2gymchrysoupolis/2gym-sensors/MEASUREMENTS.png

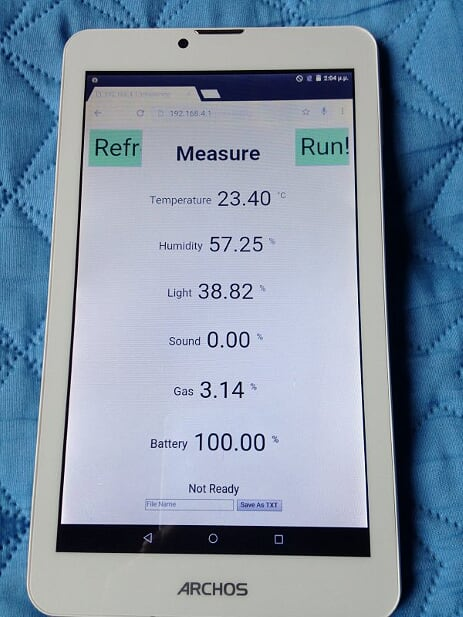
MEASUREMENTS.png
