2gymchrysoupolis/2gym-sensors/IMG_0323.JPG

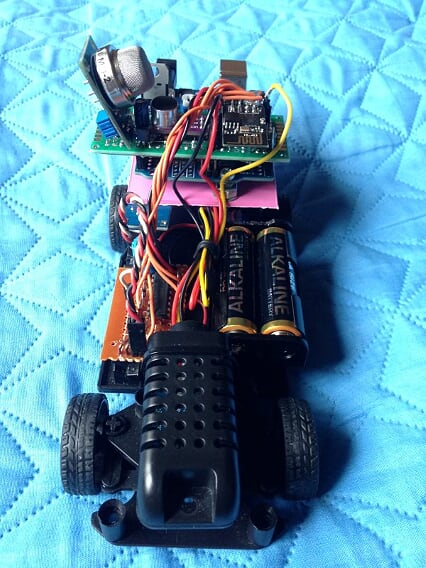
IMG_0323.JPG
