2gymchrysoupolis/2gym-sensors/README.md

# 2gym-sensorsΤο έργο μας έχει σκοπό:
Να καλλιεργήσει το ομαδικό πνεύμα και την συνεργασία των μαθητών προς ένα κοινό στόχο.
Να εμπλουτίσει τις γνώσεις τους σε ένα καινοτόμο τομέα και να τους ανοίξει ορίζοντες για την μετέπειτα εξέλιξή τους.
Να ενθαρρύνει τους μαθητές να αποκτήσουν σημαντικές δεξιότητες στην ρομποτική.
Για το έργο μας θα χρειαστούμε:
Υλικά για το περιβαλλοντικό πολύμετρο :

Όνομα / Κωδικός / Τιμή / Κατάστημα
1)Τηλεκατευθυνόμενο Αγωνιστικό Αυτοκίνητο Μπαταρίας με Χειριστήριο (1:24) - 27MHz / 1159201 / 4,99 € / JUMBO
2)ΑΛΚΑΛΙΚΗ ΜΠΑΤΑΡΙΑ ΑΑ 1.5 V LR6 BLISTER 5τεμ (4+1) - (147-24153) EUROLAMP / 13911 / 0,99 € / caliston.gr
3)CJMCU-9812 MAX9812L Electret Microphone Amplifier Development Board / 070.9469 / €3.30 / hellasdigital
4)DHT21 AM2301 Digital Temperature Humidity Sensor module with SHT11 SHT15 for Arduino / 070.0547 / €6.50 / hellasdigital
5)2*9.5mm active buzzer 5V / 070.9248 / €0.40 / hellasdigital
6)ESP8266 ESP-01 WiFi Serial Transceiver Module LWIP AP+STA for Arduino / 054.0332 / €4.19 / hellasdigital
7)RGB Diffused Common Cathode 5mm LED / 070.1500 / €0.25 / hellasdigital
8)Photo Light Sensitive Resistor 5mm GL5539 / 054.0303 / €0.15 / hellasdigital
9)SET OEM UNO R3 (ATmega328P) includes USB Cable, 40pin Headers Compatible with Arduino IDE / 033.0826 / €6.94 / hellasdigital
10)Αντίσταση Carbon 1/4W 5% 1Kohm / SKU: 05-00145029 / €0.01 x 10 = €0.10 / GROBOTRONICS
11)Transistor PNP 0.5A - BC327 / SKU: 05-00213533 / €0.08 x 2 = €0.16 / GROBOTRONICS
12)Transistor NPN 0.8A - BC337 / SKU: 05-00213524 / €0.08 x 2 = €0.16 / GROBOTRONICS
13)DC Power Plug 5.5x2.1mm – Angled / SKU: 05-00006370 / €0.25 / GROBOTRONICS
14)Battery Holder 2xΑΑ - with Wires / SKU: 05-00032199 / €0.40 / GROBOTRONICS
15)Prototyping Board 30x70mm Double-Sided / SKU: 19-00030706 / €0.50 / GROBOTRONICS
16)MQ-2 Smoke Gas Butane Hydrogen Gas Sensor Module For Arduino/ 054.0418 /€3.50 / hellasdigital

Εργαλεία:

1) Θερμοκόλλα
2) Κολλητήρι
3) Νυστέρι

Προτεινόμενο κόστος 32.78 ευρώ
