2gymchrysoupolis/2gym-sensors/ΜΕΤΡΗΣΕΙΣ-ΚΩΔΙΚΟΙ.docx

Μετρήσεις-Κωδικοί

Επίσης παρατίθενται κάποιοι κωδικοί χρήσης του πολύ-αισθητήρα που είναι οι παρακάτω:

Buzzer

Ανάβει συνεχόμενα: Κόρνα.

Αναβοσβήνει σύντομα 3 φορές: Η μέτρηση ολοκληρώθηκε, χωρίς επικίνδυνα αέρια.

Αναβοσβήνει παρατεταμένα 3 φορές: Η μέτρηση ολοκληρώθηκε, με παρουσία επικίνδυνου αερίου.

LED

Aναβοσβήνει ομαλά πράσινο: Το αμαξάκι λειτουργεί, δεν κινείται, δεν μετράει.

Αναβοσβήνει ομαλά πράσινο με πορτοκαλί: Το αμαξάκι κινείται.

Αναβοσβήνει κόκκινο: Χαμηλή μπαταρία, το αμαξάκι απενεργοποιείται.

Αναβοσβήνει ομαλά κόκκινο με μπλε: Γίνεται μέτρηση.

Αναβοσβήνει ομαλά πράσινο με μπλε: Η μέτρηση ολοκληρώθηκε με επιθυμητά νούμερα.

Αναβοσβήνει ομαλά πράσινο με κόκκινο: Η μέτρηση ολοκληρώθηκε με μη επιθυμητή υγρασία ή θερμοκρασία.

Αναβοσβήνει μπλε και κόκκινο: Η μέτρηση ολοκληρώθηκε με παρουσία επικίνδυνου αερίου.

Wire colors

Μαύρο: Γείωση

Κόκκινο: 5V

Πορτοκαλί: 3.3V

Κίτρινο: Analog Inputs

Πράσινο: Σειριακή Επικοινωνία

Γαλάζιο: Digital Pins

Μπλε: Άλλο

Μωβ: 7.2V

Όχρα: V_battery
