2gymchrysoupolis/2gym-sensors/ΟΜΑΔΑ ΕΡΓΑΣΙΑΣ-ΥΠΕΥΘΥΝΟΣ ΚΑΘΗΓΗΤΗΣ.docx

ΜΑΘΗΤΕΣ

1. ΧΡΥΣΟΠΟΥΛΟΣ ΓΙΩΡΓΟΣ ΤΜΗΜΑ Γ3

2. ΚΥΖΑΚΗΣ ΑΝΤΩΝΗΣ ΤΜΗΜΑ Γ2

3. ΛΕΙΒΑΔΙΤΟΥ ΧΡΥΣΟΥΛΑ-ΠΑΡΑΣΚΕΥΗ ΤΜΗΜΑ Β2

4. ΛΟΥΛΙ ΣΙΝΤΟΡΕΝΑ ΤΜΗΜΑ Β2

5. ΜΑΛΛΙΟΣ ΓΙΑΝΝΗΣ ΤΜΗΜΑ Β2

ΥΠΕΥΘΥΝΟΣ ΚΑΘΗΓΗΤΗΣ: Δρ. ΦΙΛΟΘΟΔΩΡΟΣ ΕΥΑΓΓΕΛΟΣ

ΒΟΗΘΟΣ ΚΑΘΗΓΗΤΗΣ: ΠΑΠΑΤΖΙΚΑΚΗ ΜΑΡΙΑ
