2gymchrysoupolis/2gym-sensors/ΕΠΙΔΙΩΞΕΙΣ.docx

ΕΠΙΔΙΩΞΕΙΣ

Με βάση έρευνα της αμερικανικής κυβέρνησης, φαίνεται ο SARS-Cov2 να αποδυναμώνεται πιο γρήγορα όταν εκτίθεται στον ήλιο, τη ζέστη και την υγρασία, μία ένδειξη ότι η πανδημία ίσως εξαπλώνεται με πιο αργούς ρυθμούς το καλοκαίρι. Λαμβάνοντας υπόψιν ότι οι υψηλές θερμοκρασίες στην Ελλάδα αρχίζουν περί τα τέλη Απριλίου με αρχές Μαΐου είναι ένα αρχικό έναυσμα για να μετρήσει κανείς αυτά τα μεγέθη μέσα σε σχολικές τάξεις που εν δυνάμει αποτελούν από τους σημαντικότερους λόγους διασποράς της ίωσης. Τα ευρήματα αυτά ενισχύουν τις ελπίδες ότι ο κορονοϊός θα μιμηθεί τη συμπεριφορά άλλων αναπνευστικών ασθενειών, όπως η γρίπη, οι οποίες είναι λιγότερο μολυσματικές όταν αυξάνεται η θερμοκρασία. Επίσης η συγκεκριμένη έρευνα έδειξε ότι ο ιός χάνει την ισχύ του κατά τρεις φορές σε περιβάλλον υψηλής υγρασίας και αν αυτό συνδυαστεί και με το φως του ήλιου η διαδικασία αυτή επιταχύνεται ραγδαίως. Πρακτικά θερμοκρασίες άνω των 22 ⁰C και ποσοστά υγρασίας μεγαλύτερα του 60% δημιουργούν μεγάλη δυσκολία στον ιό ώστε να μεταδοθεί (Από άρθρα σε διαδίκτυο). Αυτό συμβαίνει διότι αυτές οι κλιματικές συνθήκες δεν επιτρέπουν σε ιούς της μορφής SARS να παραμένουν στον αέρα και τους ρίχνουν στο έδαφος στο οποίο έχουν μέση διάρκεια ζωής το πολύ 3 ώρες.

Επίσης οι υπόλοιποι αισθητήρες της διάταξης μπορούν να δώσουν τιμές αερίων, φωτός και ήχου μέσα σε έναν κλειστό χώρο όπως μία σχολική τάξη και να γίνει σύγκριση των τιμών αυτών με ιδανικές συνθήκες διαβίωσης και αλληλεπίδρασης μεταξύ των ανθρώπων σε έναν χώρο από τη στιγμή που φαινόμενα όπως η αντήχηση, ο κακός ή υπερβολικός φωτισμός και οι εξωτερικοί θόρυβοι ειδικά σε σχολικά συγκροτήματα που βρίσκονται εντός του κύριου αστικού όγκου, επιβραδύνουν και μειώνουν το επίπεδο της σχολικής διαδικασίας.
