2gymchrysoupolis/2gym-sensors/IMG_0276.JPG

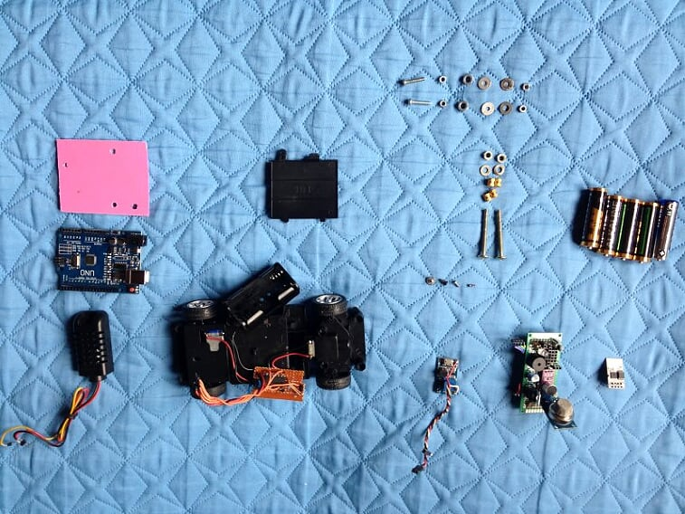
IMG_0276.JPG
