2gymchrysoupolis/2gym-sensors/IMG_0277.JPG

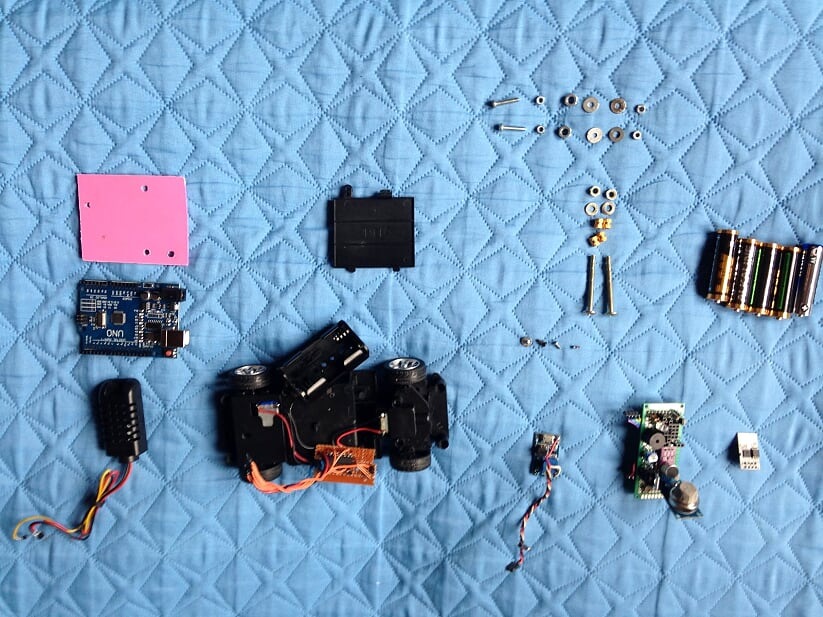
IMG_0277.JPG
