2gymchrysoupolis/2gym-sensors/IMG_0279.JPG

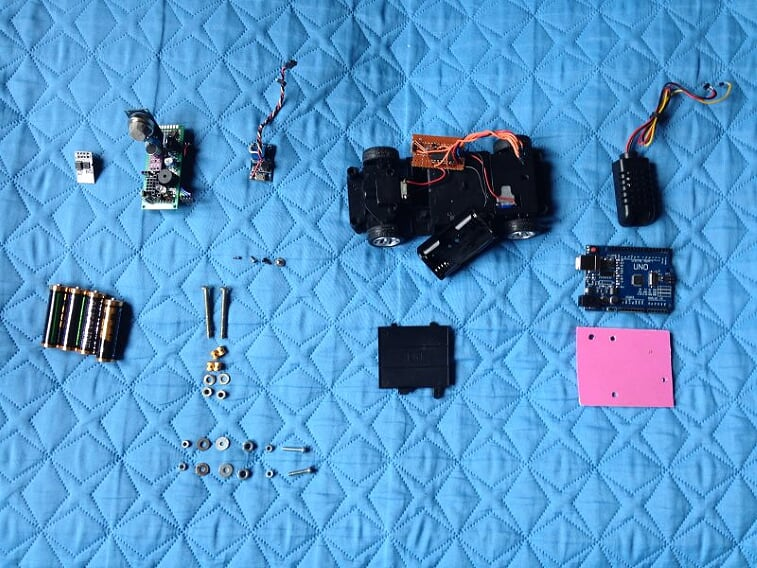
IMG_0279.JPG
