2gymchrysoupolis/2gym-sensors/IMG_0282.JPG

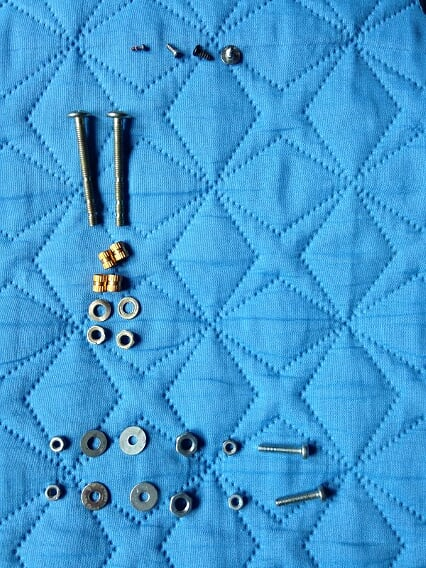
IMG_0282.JPG
