2gymchrysoupolis/2gym-sensors/IMG_0283.JPG

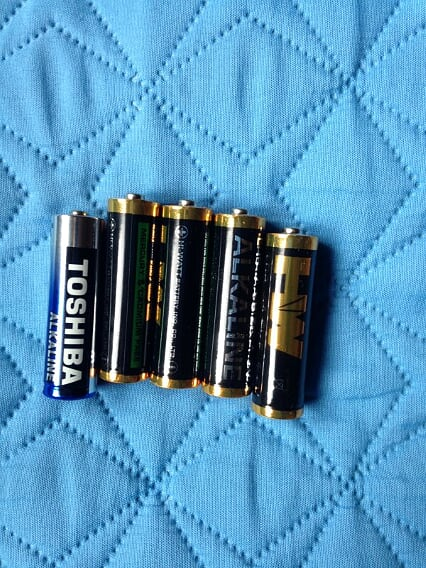
IMG_0283.JPG
