2gymchrysoupolis/2gym-sensors/IMG_0285.JPG

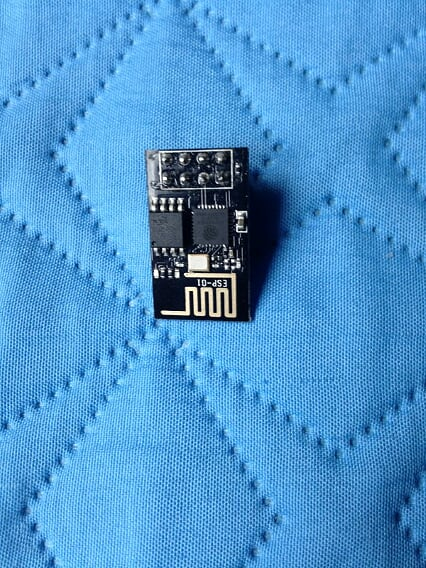
IMG_0285.JPG
