2gymchrysoupolis/2gym-sensors/IMG_0286.JPG

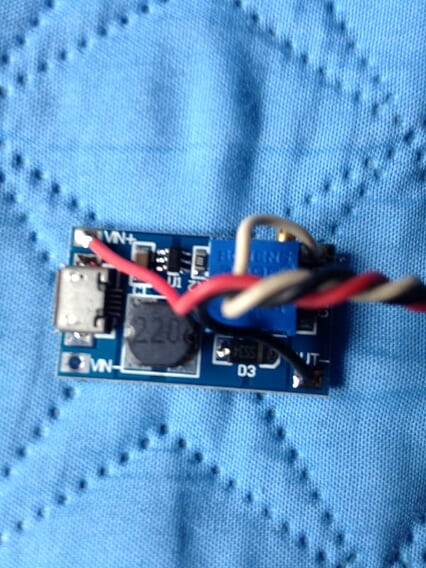
IMG_0286.JPG
