2gymchrysoupolis/2gym-sensors/IMG_0287.JPG

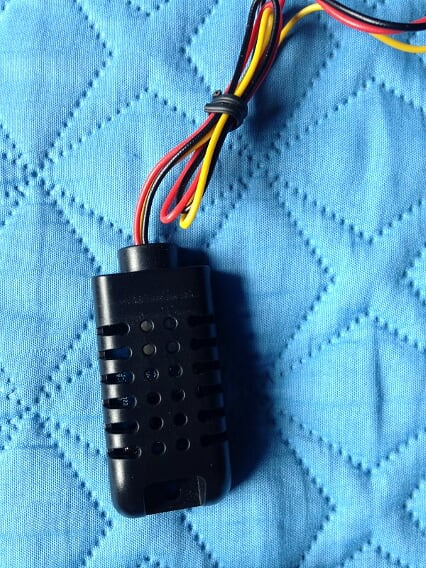
IMG_0287.JPG
