2gymchrysoupolis/2gym-sensors/IMG_0288.JPG

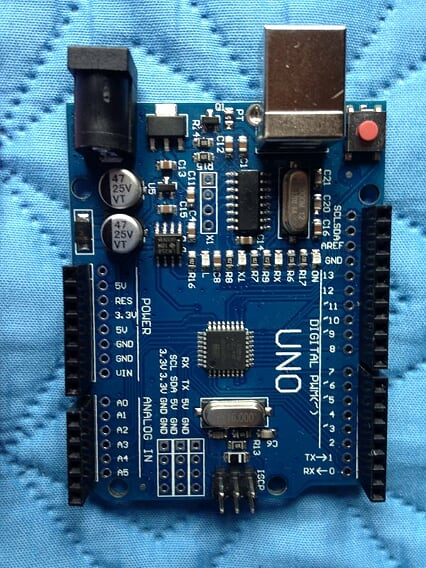
IMG_0288.JPG
