2gymchrysoupolis/2gym-sensors/IMG_0289.JPG

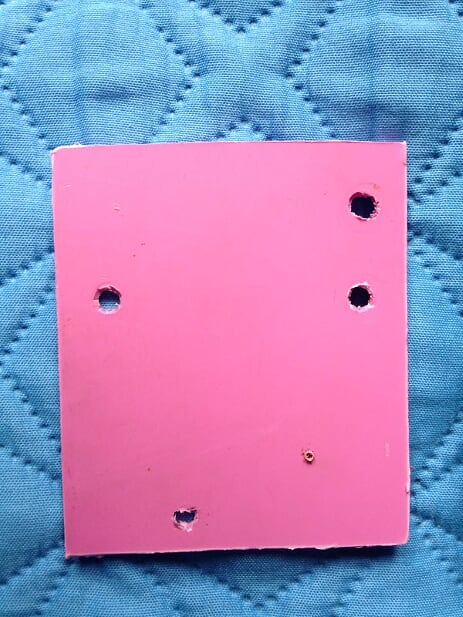
IMG_0289.JPG
