2gymchrysoupolis/2gym-sensors/IMG_0290.JPG

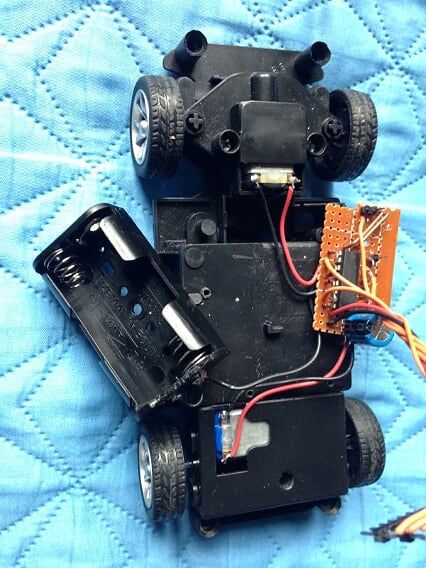
IMG_0290.JPG
