2gymchrysoupolis/2gym-sensors/IMG_0292.JPG

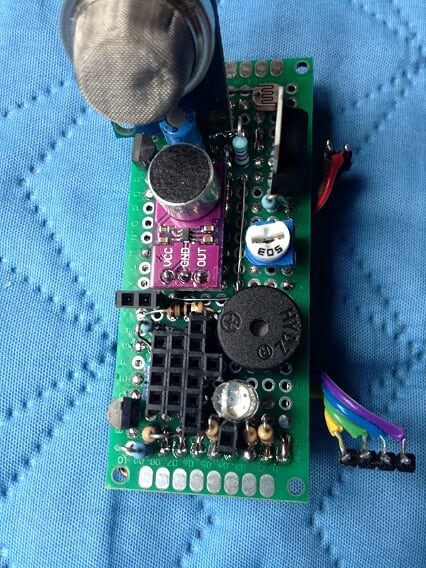
IMG_0292.JPG
