2gymchrysoupolis/2gym-sensors/IMG_0296.JPG

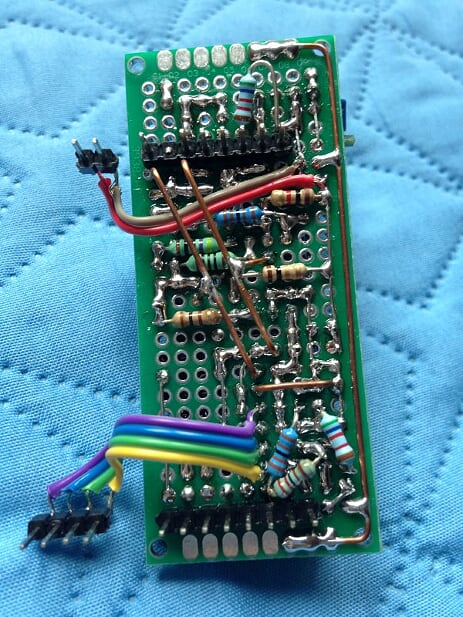
IMG_0296.JPG
