2gymchrysoupolis/2gym-sensors/IMG_0299.JPG

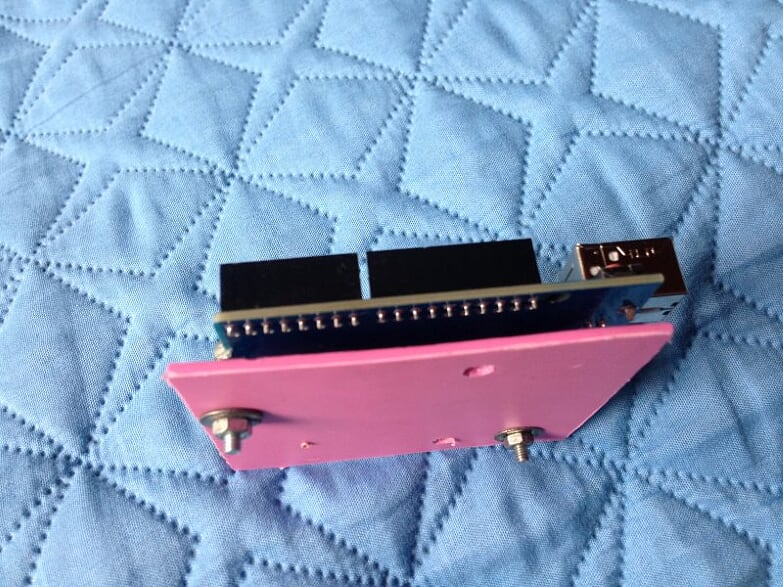
IMG_0299.JPG
