2gymchrysoupolis/2gym-sensors/IMG_0305.JPG

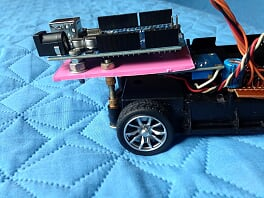
IMG_0305.JPG
