2gymchrysoupolis/2gym-sensors/IMG_0306.JPG

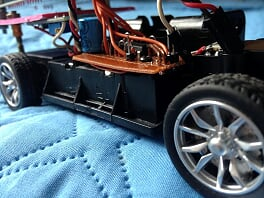
IMG_0306.JPG
