2gymchrysoupolis/2gym-sensors/IMG_0308.JPG

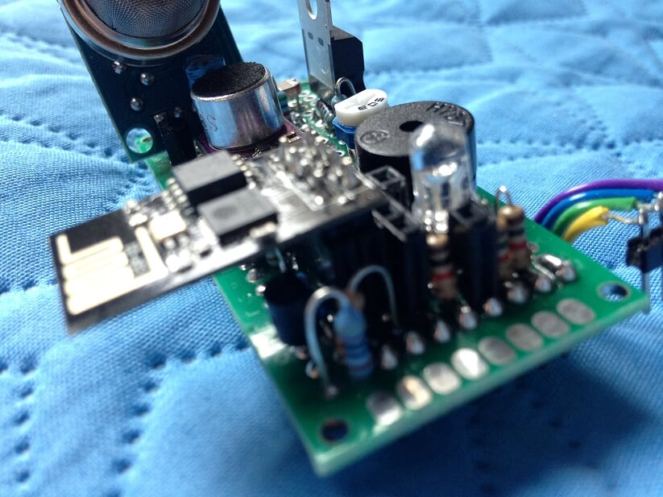
IMG_0308.JPG
