2gymchrysoupolis/2gym-sensors/IMG_0310.JPG

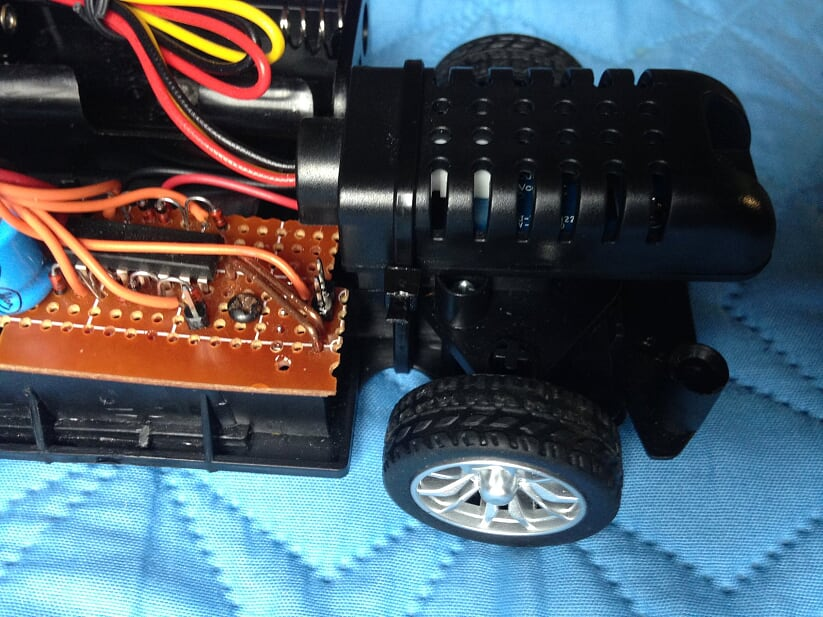
IMG_0310.JPG
