2gymchrysoupolis/2gym-sensors/IMG_0314.JPG

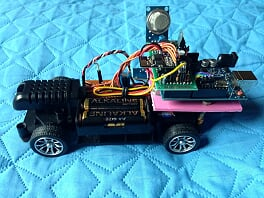
IMG_0314.JPG
