2gymchrysoupolis/2gym-sensors/IMG_0319.JPG

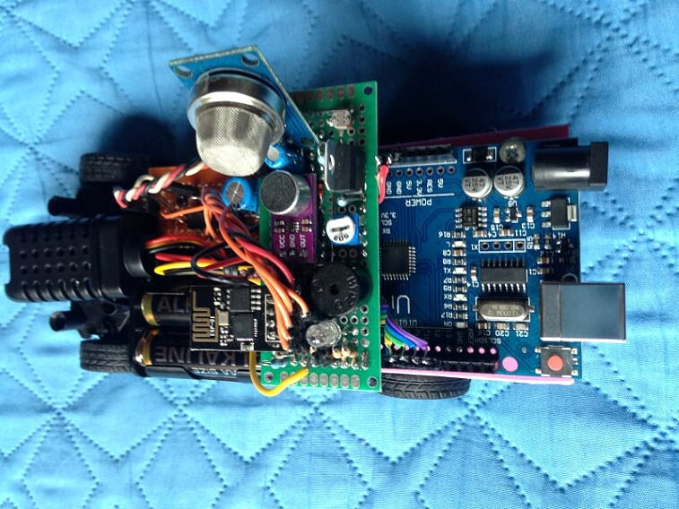
IMG_0319.JPG
