2gymchrysoupolis/2gym-sensors/IMG_0322.JPG

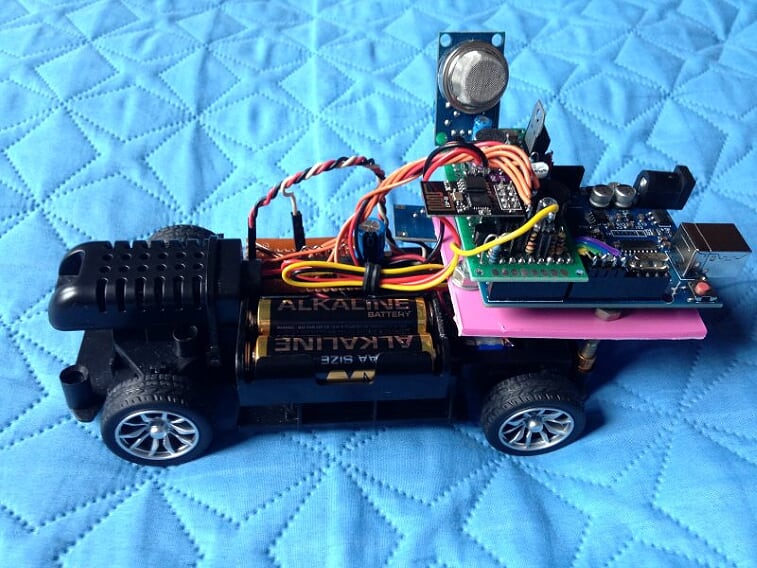
IMG_0322.JPG
