2gymchrysoupolis/2gym-sensors/Mulrisensor circuit.png

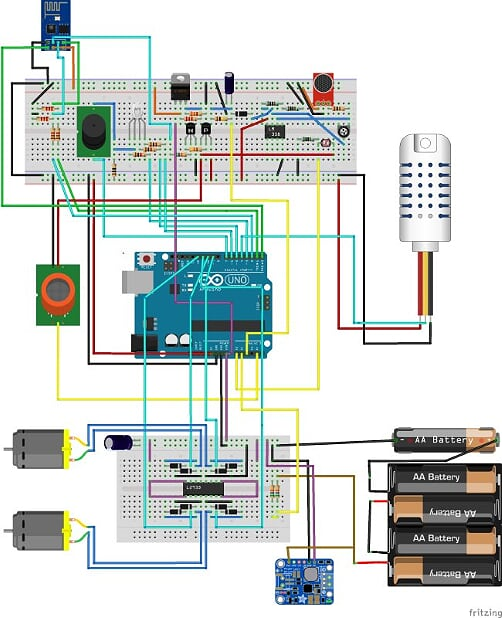
Mulrisensor circuit.png
