2gymchrysoupolis/2gym-sensors/NETWORK.png

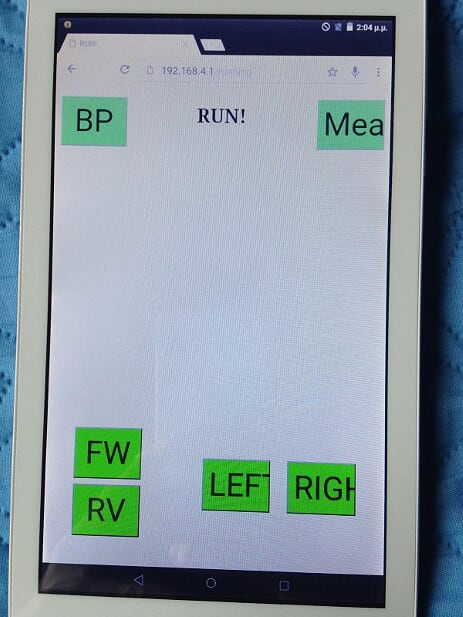
NETWORK.png
